VK12034/exo-arm/cad/README.md

# CAD

BudgetExoArm

The mechanical design, as modelled in Fusion 360.

| File | What it is |
|---|---|
| `source/BudgetExoArm.f3d` | Fusion archive of the design |
| `step/BudgetExoArm.step` | STEP export, openable without Fusion |
| `mesh/BudgetExoArm.stl` | Mesh export. GitHub renders this in the browser |
| `BudgetExoArm.design.json` | Every component, body and joint, with mass, volume and centre of mass |
| `BudgetExoArm.bodies.csv` | The same body data as a spreadsheet |
| `parts/` | One STL per 3D-printed part, in model position, so lay each flat in the slicer |

All of these except the image are generated by `tools/fusion/ExoArmExport.py`.
Run it again after any design change so the numbers below, and the constants
in the firmware, stay tied to the model rather than to memory.

## Regenerating

The script is installed per-machine, not from this repository:

1. Copy `tools/fusion/` contents into a folder named `ExoArmExport` under
   `%APPDATA%\Autodesk\Autodesk Fusion 360\API\Scripts\` (Windows) or
   `~/Library/Application Support/Autodesk/Autodesk Fusion 360/API/Scripts/` (macOS)
2. Open the design, then **Utilities → Scripts and Add-Ins → ExoArmExport → Run**
3. Point it at this `cad/` folder

It only reads and exports. It also refuses to run if the timeline marker is
not at the end, because a rolled-back timeline exports a mid-edit state as if
it were the design. That happened once, and this repository described the wrong
machine until it was caught.

## Coordinate frame

Fusion's origin sits at the wearer's right shoulder. Z is up, so the arm
hangs in −Z. X runs forward, the direction the forearm points in the modelled
pose. Y runs to the wearer's left, where the drivetrain is mounted.

Figures are millimetres and kilograms, taken from the model unless marked as
calculated.

## Layout

| Item | Position (mm) | Notes |
|---|---|---|
| Shoulder centre | (0, 0, −10) | Wearer reference |
| Elbow axis | Along Y, through x = 0, z = −330 | M8 shoulder bolt in two bronze bushings |
| Gearbox output and 15T sprocket | Along Y, through x = 0, z = −172 | 158 mm above the elbow |
| 30T elbow sprocket | y 77.6 to 82.9 | Moves with the forearm |
| Upper strut | y 62.0 to 66.8, z −374 to −64 | 1.5 × 3/16 in 6061 |
| Forearm strut | y 67.8 to 72.6, x −33 to 253 in the modelled pose | 1 × 3/16 in 6061 |
| Forearm cuff | Centred at x = 193 | 193 mm from the elbow |

## Elbow travel

"Flexion" here means the true angle from a straight arm. The modelled pose is
90°, with the upper arm along −Z and the forearm along +X.

| Point | True flexion | Firmware angle | Source |
|---|---|---|---|
| Extension stop contact | about 21.2° | about −2.4° | Calculated from the measured gap at the joint limit |
| Fusion joint limit, extension | 22° | −1.5° | Joint limit |
| Home switch closes | about 23.5° | 0° | Modelled target, see below |
| Flexion soft limit | about 111.5° | 88° | `kMaxAngleDeg` |
| Overrun switch closes | about 114.5° | 91° | Modelled target, `kFlexSwitchAngleDeg` |
| Fusion joint limit, flexion | 117° | 93.5° | Joint limit |
| Flexion stop contact | about 117.6° | about 94.1° | Calculated from the measured gap at the joint limit |

So the arm never fully straightens, and travel is about 96° between the stops.
The firmware's zero is the home switch, not a straight arm: add about 23.5° to
a firmware angle to get true flexion.

The hard stops are 7 mm steel spacers in 10 mm OD rubber sleeves on the upper strut,
each 30 mm from the pivot, and the forearm strut's edge strikes the rubber. The
sleeves keep the same 10 mm contact as the original spacers, so the stop angles did
not change, though the rubber will compress a little under load. Their M5 × 10 bolts
screw into tapped spacers and must end below the top of the spacer, because the clutch
plate sweeps over them.

## Switch mounts

Two KW12-style lever microswitches, each on a 3 mm 6061 bracket on the inboard
face of the upper strut, with the switch standing on 4.9 mm spacers so the
lever sits in the forearm strut's plane. Each bracket takes two M3 screws
through 3.2 mm holes in the upper strut, and the switches use 2.4 mm holes on
9.5 mm centres.

Checked by rotating the real elbow joint through its limits at 15 poses:

| Check | Result |
|---|---|
| New parts clashing with anything except the strut pressing a lever | None |
| Home lever first touched | About 25.6° true flexion |
| Overrun lever first touched | About 112.1° true flexion |
| Strut to home switch body at the 22° joint limit | 2.0 mm |
| Strut to overrun switch body at the 117° joint limit | 1.3 mm |
| Mass of every other existing body after the work | Unchanged |

**The closing angles are a target, not a measurement.** The levers are simple
modelled shapes placed so a real switch with about 1.2 mm of lever pre-travel
would close at the target angle. Real switches differ, so
[commissioning](../docs/commissioning.md) measures both closing points on the
built arm, and those measurements decide.

## Control box and pendant

Both enclosures are sized for real parts rather than the model's earlier simple blocks.

**Control box**, 58 × 156 × 116 mm outside, with 3 mm walls. It opens toward the lid, away
from the wearer, and the belt loops are part of its closed back wall.

| Feature | Size |
|---|---|
| Uno bosses | 7 mm OD × 6 mm, Ø2.5 pilots, on the Uno's standard hole pattern |
| TB6600 | Space for 96 × 71 × 37 mm. Mounting holes vary by maker, so mark and drill the back wall from yours |
| Glands | Ø12.5 in the top and end walls |
| USB opening | 14 × 16 mm in the end wall, so the Uno can be flashed with the lid on. Check it against your board |
| Vents | 5 slots in the lid over the driver, 4 in the end wall beside it |
| Lid | Rocker 19.2 × 13 mm, LED Ø6.2, barrel jack Ø12, 4 Ø3.4 screw holes into Ø2.5 pilots |

The barrel jack moved to clear the driver. The fuse, capacitor and wiring are not modelled,
and nothing has been test-fitted.

**Pendant**, 50 × 108 × 55 mm outside, 3 mm walls. That leaves 49 mm behind the panel,
because published 22 mm e-stops range from about 18 to 72 mm deep, and typically 37 to
46 mm. Check yours. It has Ø16 button holes, a Ø22.3 e-stop hole, a Ø9 cable hole, and a
screw-on back cover that carries the belt clip. It is bigger than before, and neither the
grip nor the weight with real switches has been tried.

Checked with the enclosures in place: no overlaps inside the harness apart from the cables
entering their glands, and neither enclosure touches the reference wearer.

## Chain tension

The gearbox plate's three standoffs run in slots in the upper strut, 5.5 mm wide and
15.5 mm long overall, so the plate slides about 5 mm each way along the strut. Slide it
away from the elbow to tighten the chain, then tighten the M5 × 35 bolts.

## Chain guard

A printed PETG channel around the chain and both sprockets, y 73.6 to 90, with 2 mm
walls. It is held by two pillars at x = ±8, z = −276 with M3 screws through the upper
strut. There is no cover under the gearbox plate, which roofs that end, and the
forearm strut passes underneath the walls. The rigidity of a 2 mm channel on two
pillars is a guess until one is printed.

## Encoder mount

A printed cup screwed to the clutch's outer plate turns with the forearm and carries a 6
× 2.5 mm diametric magnet on the elbow axis, clear of the stationary M8 nut. The clutch
nuts and springs pass through holes in it. An AS5600 board on an arm from the chain
guard sits above it with a 1.5 mm gap.

Printed tolerances and the guard's stiffness could still close the 1.5 mm gap or
misalign the magnet, and so could moving the outer plate when the clutch is adjusted.

## Torque limiter

A friction clutch between the 30T sprocket and the forearm, fully described in
[torque-limiter.md](../docs/torque-limiter.md). It takes the 5 mm that the sprocket
spacers used, so the sprocket and chain line have not moved.

Checked at 11 elbow angles across the joint's full range, for the clutch parts,
sprocket, cup and nuts:

| Check | Result |
|---|---|
| Clashes with the upper arm, switches and guard | None, leaving aside the chain, which is modelled as a fixed loop with teeth that do not follow the sprocket |
| Overlaps within the forearm stack | None |
| Plate to the top of the overrun and home switches | 0.8 mm |
| Plate edge to the modelled chain | 2.0 mm |
| Bodies not deliberately changed | Mass unchanged |

The bolts' shanks and the countersinks for the two extra bolts are not modelled.

## Mass

| Component | Mass (kg) | Bodies | Notes |
|---|---|---|---|
| Upper Arm Module | 2.370 | 43 | Gearbox 1.10, motor 0.55, chain 0.27, struts, cuff, 15T sprocket |
| Harness + Electronics | 0.713 | 28 | Waist belt, control box, pendant. Carried by the torso |
| Forearm Module | 0.600 | 29 | Clutch 0.255, bored 30T sprocket 0.174, strut, cuff, magnet cup |
| Chain Guard | 0.044 | 2 | Guard and encoder board |
| Switch Mounts | 0.013 | 10 | Added for the home and overrun switches |
| **Device total** | **3.741** | 112 | |
| Ref - Wearer Torso | 6.213 | 8 | Reference mannequin, not part of the device |
| Ref - Wearer Upper Arm | 0.336 | 2 | Reference solid |
| Ref - Wearer Forearm | 0.185 | 4 | Reference solid |

The motor's 0.55 kg is the listing's gross weight, spread over its modelled bodies. The
gearbox's 1.10 kg is its share of an earlier estimate for the whole gearmotor, not a
figure for the part you will buy.

The `Ref - Wearer` bodies are shape references at an arbitrary density. Their
masses are **not** anthropometric and must not be used for load calculations.
Use published segment fractions against the wearer's own body mass instead.

Bronze bushings are still assigned steel in the model. The error is a few grams and does
not affect any figure here. The clutch adds about 0.17 kg, almost all of it close to the
elbow axis, so the static load does not change.

## Drivetrain

| Item | Value |
|---|---|
| Motor | NEMA 23 stepper, 41 mm body, 0.55 N·m holding |
| Gearbox | NMRV030 worm, 30:1 |
| Chain stage | #35, 15T to 30T, 2:1, 56 links |
| Overall ratio | 60:1 |
| Resolution | 200 full steps × 4 microsteps × 60 = 48 000 steps per elbow revolution |
| Ideal output | 33 N·m calculated, before worm and chain losses |
| Assist | 1/4 in shock cord, 3 loops, between the upper arm and a pin on the forearm |

Catalogue efficiencies give 12 to 21 N·m at the elbow at full motor torque. See
[loads](../docs/loads.md).

**The worm should hold, but that is untested.** Motovario lists the NMRV030 at 30:1
with a static efficiency of 0.39, below the 0.5 it requires. Vibration can still affect
that, and a chain failure would release the forearm whatever the worm does.

## Electronics

| Item | Where |
|---|---|
| Arduino Uno | Control box, waist belt |
| TB6600 stepper driver | Control box, waist belt |
| 24 V barrel jack, rocker switch, green status LED | Control box face |
| UP and DOWN momentary buttons | Hand pendant |
| E-stop, latching mushroom, normally closed | Hand pendant |
| PG7 glands, 6-core pendant cable, 4-core motor cable | Control box |
| Buck converter, e-stop relay, ACS712 | Control box, on the back wall |
| AS5600 encoder board | On the chain guard, over the elbow axis |

## Materials

| Material | Used for |
|---|---|
| PETG, FDM, 4 walls at 40% infill | Cuffs, gearbox plate, control box, pendant housing, strap anchor, chain guard, magnet cup |
| Aluminium 6061 | Upper and forearm struts, standoffs, switch brackets and spacers |
| Steel | Sprockets, clutch plates and shim, hard stop spacers, pivot bolt, fasteners, shaft key |
| Aluminium 6061, machined | Clutch hub |
| Organic friction sheet, 1 mm | Clutch facings, density assumed |
| Rubber | Hard stop sleeves |
| EVA foam, 5 mm | Cuff pads |
| Nylon webbing, 25 and 38 mm | Sling strap, waist belt |

## Not modelled or not checked

- [First-pass stall loads](../docs/loads.md) exist, but contact stress, strut bending,
  the gearbox plate and the shoulder mount have not been checked.
- The encoder and sensor wiring runs are not modelled.
- [The clutch](../docs/torque-limiter.md) has not been built, and its friction is assumed.
