VK12034/exo-arm/cad/BudgetExoArm.bodies.csv

occurrence | component | body | material | mass_kg | volume_mm3 | com_x_mm | com_y_mm | com_z_mm | size_x_mm | size_y_mm | size_z_mm
/Ref - Wearer Torso:1 | Ref - Wearer Torso | Torso | Fabric | 4.829456602230147 | 31772740.80414571 | -5.614805690907065 | -190.00000003856738 | -222.48301347356352 | 226.6768406649028 | 344.0099099489128 | 660.0
/Ref - Wearer Torso:1 | Ref - Wearer Torso | Head + Neck | Fabric | 0.6488113729929531 | 4268495.874953639 | -5.90256741804378 | -189.99999999999997 | 250.62307297081225 | 184.00000000000003 | 184.00000000000006 | 298.7323711720972
/Ref - Wearer Torso:1 | Ref - Wearer Torso | Right Shoulder | Fabric | 0.105930315488843 | 696909.9703213357 | 0.0 | 0.0 | 0.0 | 110.0 | 110.0 | 110.0
/Ref - Wearer Torso:1 | Ref - Wearer Torso | Left Shoulder | Fabric | 0.105930315488843 | 696909.9703213357 | 0.0 | -380.0 | 0.0 | 110.0 | 110.0 | 110.0
/Ref - Wearer Torso:1 | Ref - Wearer Torso | Left Elbow | Fabric | 0.040748551112162 | 268082.573106329 | 0.0 | -392.0 | -324.99999999999994 | 80.0 | 80.0 | 80.0
/Ref - Wearer Torso:1 | Ref - Wearer Torso | Left Upper Arm | Fabric | 0.29368025524048713 | 1932106.9423716262 | -1.949298901233054e-09 | -392.0000000024876 | -153.09499201817775 | 100.0 | 99.99999999999993 | 300.0
/Ref - Wearer Torso:1 | Ref - Wearer Torso | Left Forearm | Fabric | 0.15452853175261724 | 1016635.0773198503 | 8.000000010371723 | -391.99999999577216 | -439.86280866117124 | 82.04809064756624 | 82.00000000000017 | 260.0
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
/Switch Mounts:1 | Switch Mounts | Home Switch Lever | Steel | 0.00032970000000000346 | 42.00000000000045 | 5.043051536939504 | 70.10000000000001 | -376.3318479147528 | 4.980608172205213 | 4.0000000000000036 | 21.132382186036267
/Switch Mounts:1 | Switch Mounts | Overrun Switch (KW12 lever microswitch) | ABS Plastic | 0.0013839359999999969 | 1305.599999999997 | 27.56548476648384 | 70.10000000000002 | -294.03009522408007 | 22.429096492624495 | 6.400000000000006 | 17.575469816065485
/Switch Mounts:1 | Switch Mounts | Overrun Switch Lever | Steel | 0.00029829999999999695 | 37.999999999999616 | 29.29000751795808 | 70.10000000000001 | -301.43134655609464 | 15.754899148826231 | 4.0000000000000036 | 12.155989583588322
/Chain Guard:1 | Chain Guard | Chain Guard (PETG print) | PETG (FDM, 4 walls + 40% infill) | 0.043406859728983144 | 48229.84414331461 | -0.83923797726671 | 86.07541876420662 | -285.4236275357099 | 112.00000000000001 | 37.2 | 256.0
/Chain Guard:1 | Chain Guard | AS5600 Encoder Board | ABS Plastic | 0.0008971839999999998 | 846.3999999999999 | 0.0 | 101.19999999999999 | -330.0 | 23.000000000000004 | 1.6000000000000014 | 22.99999999999997
