VK12034/exo-arm/cad/mesh/BudgetExoArm.stl

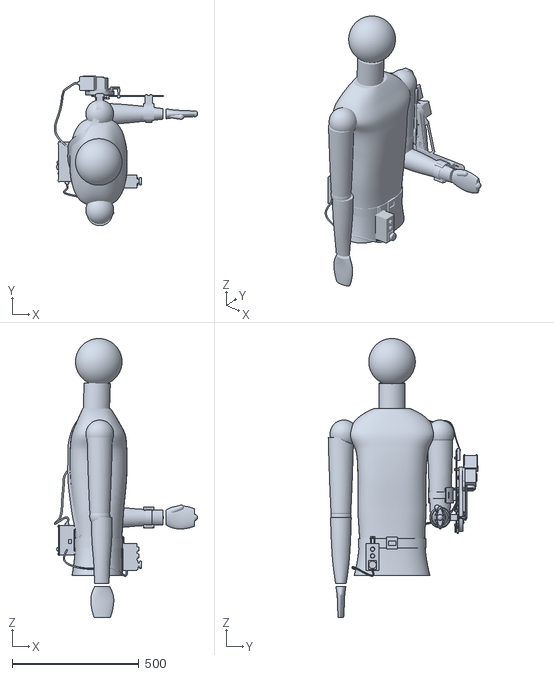
[picture p2: CAD file, 2026-11-09]
cad/mesh/BudgetExoArm.stl
566.7 x 590.5 x 1102.0
