VK12034/exo-arm/cad/parts/hand-pendant-back-cover.stl

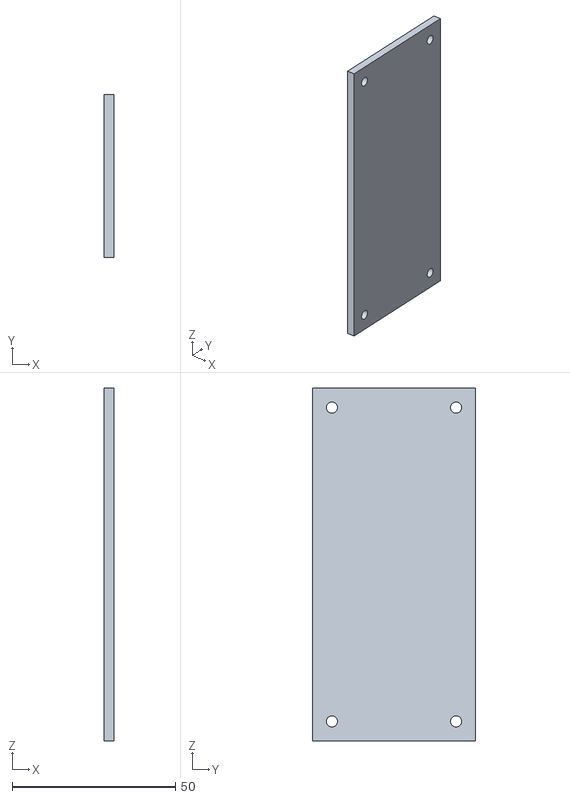
[picture p3: CAD file, 2026-11-09]
cad/parts/hand-pendant-back-cover.stl
3.00 x 50.0 x 108.0
