VK12034/exo-arm/cad/parts/sling-strap-anchor.stl

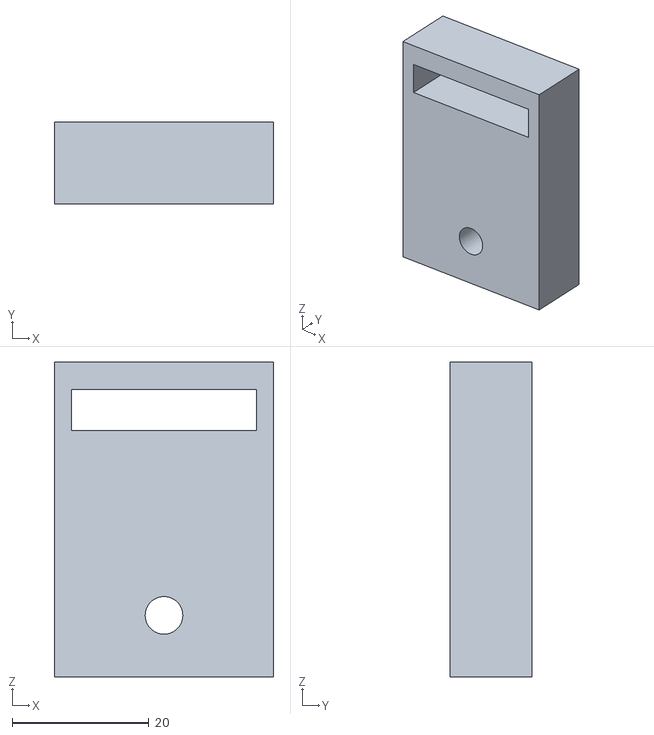
[picture p4: CAD file, 2026-11-09]
cad/parts/sling-strap-anchor.stl
32.0 x 12.0 x 46.0
