VK12034/exo-arm/cad/parts/control-box-body.stl

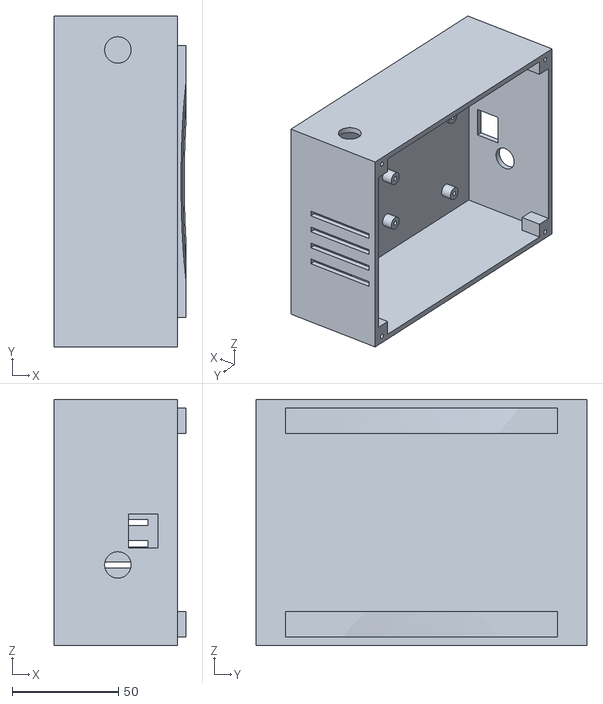
[picture p5: CAD file, 2026-11-09]
cad/parts/control-box-body.stl
62.0 x 156.0 x 116.0
