VK12034/exo-arm/cad/parts/control-box-lid.stl

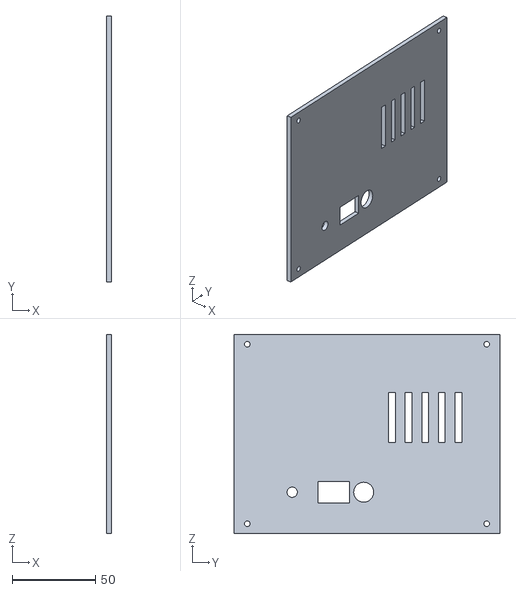
[picture p6: CAD file, 2026-11-09]
cad/parts/control-box-lid.stl
3.00 x 160.0 x 120.0
