VK12034/exo-arm/cad/parts/hand-pendant-housing.stl

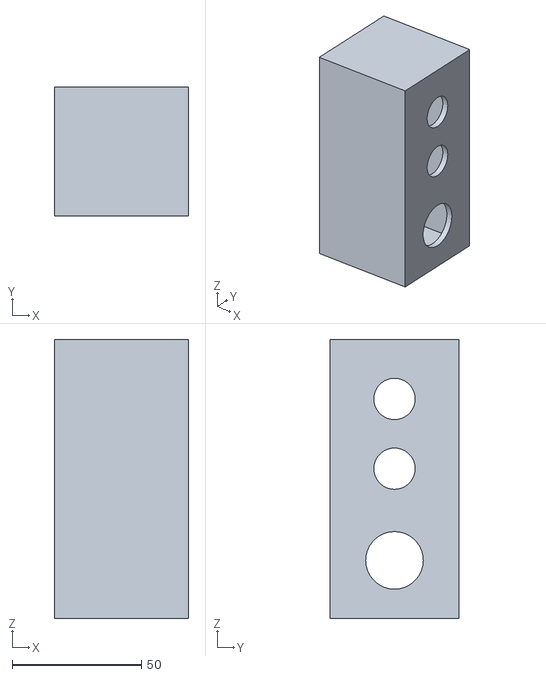
[picture p7: CAD file, 2026-11-09]
cad/parts/hand-pendant-housing.stl
52.0 x 50.0 x 108.0
