VK12034/exo-arm/cad/parts/encoder-magnet-cup.stl

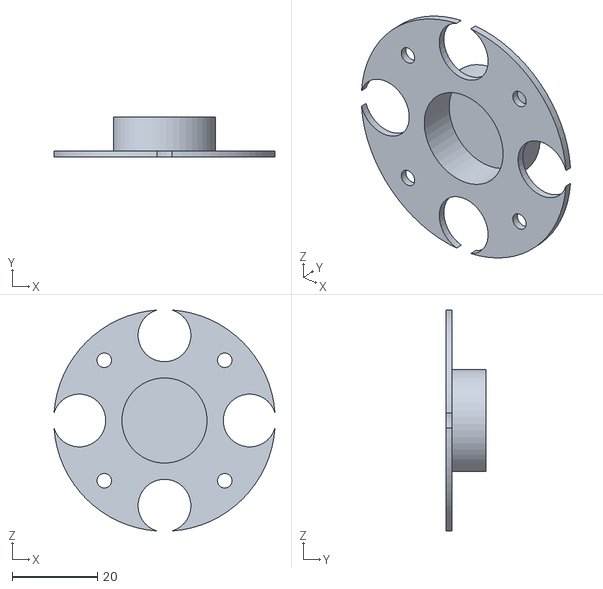
[picture p8: CAD file, 2026-11-07]
cad/parts/encoder-magnet-cup.stl
51.9 x 9.50 x 51.9
