VK12034/exo-arm/cad/parts/chain-guard.stl

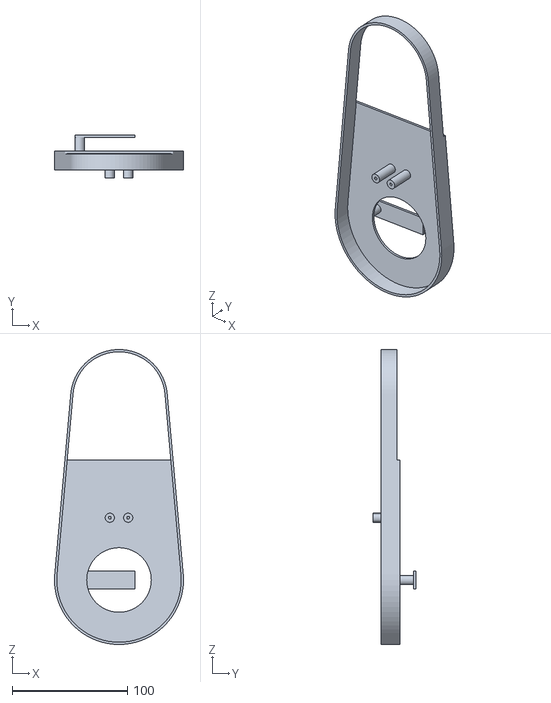
[picture p9: CAD file, 2026-11-07]
cad/parts/chain-guard.stl
112.0 x 37.2 x 256.0
