VK12034/exo-arm/cad/parts/forearm-cuff.stl

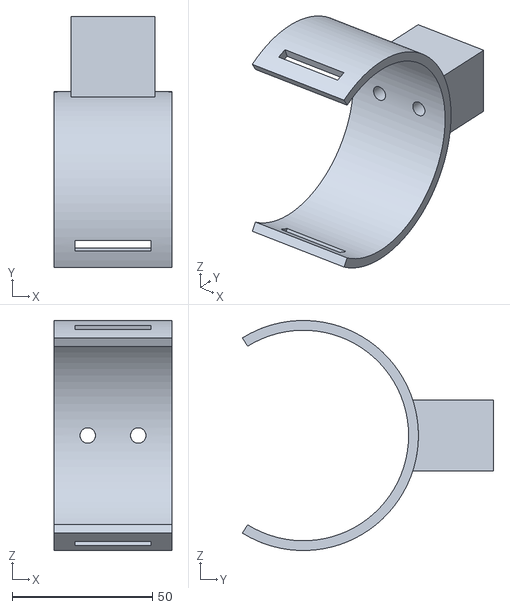
[picture p10: CAD file, 2026-11-07]
cad/parts/forearm-cuff.stl
42.0 x 89.5 x 82.0
