VK12034/exo-arm/cad/parts/upper-arm-cuff.stl

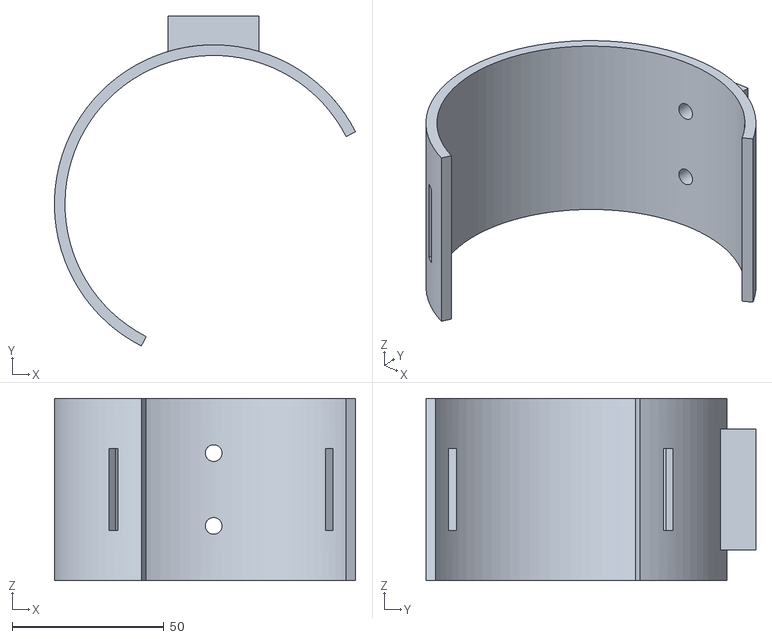
[picture p11: CAD file, 2026-11-07]
cad/parts/upper-arm-cuff.stl
99.3 x 108.8 x 60.0
