VK12034/exo-arm/cad/parts/gearbox-plate.stl

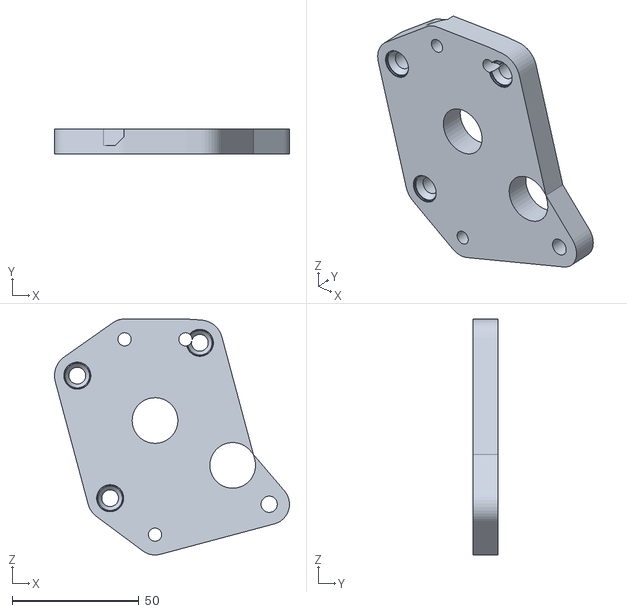
[picture p12: CAD file, 2026-11-07]
cad/parts/gearbox-plate.stl
92.6 x 10.0 x 93.0
