VK12034/exo-arm/(list of files, cad)

Other CAD files:
cad/step/BudgetExoArm.step
cad/source/BudgetExoArm.f3d
