VK12034/exo-arm/docs/wiring.md

# Wiring

Arduino Uno, 5 V logic. The pin assignments below are the firmware's, from
`firmware/include/config.h`; change the two together.

## Pin map

### TB6600 stepper driver

The TB6600's inputs are opto-isolated pairs. These pins drive the negative
sides with the positive sides tied to 5 V, so a pin pulled **low** activates
that input.

| Signal | Uno pin | TB6600 | Notes |
|---|---|---|---|
| Step | 3 | PUL− | 4 µs pulse, up to about 2.7 kHz at full speed |
| Direction | 4 | DIR− | Settled before the next pulse by the firmware |
| Enable | 5 | ENA− | Low energises the motor |
| 5 V | 5V | PUL+, DIR+, ENA+ | Common positive |

Set the DIP switches for **1/4 microstepping** and **2.0 A** to start, and never above
the motor's rated 2.8 A. `cfg::kMicrosteps` must match the switches. Step 7 of
[commissioning.md](commissioning.md) checks that it does, by measuring the
home-to-overrun span, but nothing checks it while the arm is running, and a
mismatch scales every angle in the firmware by the same wrong factor.

The current setting is also the only torque limit this machine has. Stepper
torque follows phase current, and the TB6600 holds phase current at whatever
these switches say, so this is what decides how hard the arm can push. The
firmware cannot reduce it: see the torque entry in
[safety.md](safety.md#known-gaps). Set it no higher than the arm needs.

### Pendant

Six-core cable to the hand unit, through a PG7 gland.

| Signal | Uno pin | Wiring |
|---|---|---|
| UP button | 6 | Momentary to GND, internal pull-up |
| DOWN button | 7 | Momentary to GND, internal pull-up |
| E-stop | 2 | **Normally closed** to GND, internal pull-up |
| GND | GND | Common return |

Two cores spare. Use one as a second ground rather than leaving it floating.

The e-stop must be the normally-closed contact of the latching mushroom. A
normally-open contact would read as "safe" when the cable is cut, which is
exactly backwards.

### Home switch

A lever microswitch at the extension end of travel, which is what gives the
firmware a real zero instead of an assumed one.

| Signal | Uno pin | Wiring |
|---|---|---|
| Home switch | 9 | **Normally open**, closing to GND, internal pull-up |

Note that this is the opposite convention to the e-stop, and for the same
reason: pick the polarity by how it fails.

- **Normally open**, as specified. A cut cable or an unplugged switch reads
  open forever. The arm never homes, so it stays on its restricted travel and
  runs slow. The failure is visible in the status output and costs range, not
  safety.
- **Normally closed**, which would be wrong here. The same cut cable reads as
  "at home", and the firmware would adopt a zero wherever the arm happened to
  be, then open up the full travel on the strength of it. A broken wire would
  silently move every limit.

The e-stop is normally closed because for a stop command, the safe assumption
on a broken wire is "stop". The home switch is normally open because for a
position reference, the safe assumption on a broken wire is "I do not know
where I am".

**Mounting.** The model has a 3 mm aluminium bracket for it on the inboard face
of the upper strut, with the lever in the forearm strut's plane. See
[cad/README.md](../cad/README.md).

**Siting it matters.** The switch can only be acted on once it closes, so the
arm travels a little further while stopping, and that overshoot has to fit
between the switch and the hard stop. The firmware seeks at 5 °/s, which is
0.28° of stopping distance at 45 °/s², so a degree of clearance is ample.
The model targets closing about 2.5° before the hard stop. It must stay closed
all the way to the stop, rather than closing exactly at the stop. A switch that
closes only at the very end can be driven past before the firmware reacts.

### Overrun switch

A second lever microswitch, sited **past** the flexion soft limit rather than
at it.

| Signal | Uno pin | Wiring |
|---|---|---|
| Overrun switch | 10 | **Normally open**, closing to GND, internal pull-up |

Same polarity as the home switch, same reasoning. It closes at a firmware angle
of about **91°**, three degrees beyond the 88° soft limit and about three before
the flexion hard stop.

This one is not a limit. The planner stops at 88° and the step generator
refuses to pulse past it on its own arithmetic, so reaching this switch means
both of those failed. That is why it faults rather than merely stopping.

Siting it is a compromise in both directions:

- **Too close to the soft limit** and a normal full-flexion stop brushes it,
  which means nuisance faults and a safety device that gets disconnected.
  Three degrees is several times any plausible overshoot.
- **Too far past it** and the arm travels further into trouble before anything
  notices, with less room left before the hard stop.

Note the failure mode. A broken home switch announces itself within a session,
because the arm never homes and says so. A broken overrun switch is silent
until the day it is needed, and that day is already a bad one. Step 7 of
[commissioning.md](commissioning.md) is the only thing that proves it works,
so do it rather than assuming.

Its bracket is in the model too. See [cad/README.md](../cad/README.md).

### Panel

| Signal | Uno pin | Notes |
|---|---|---|
| Status LED | 8 | Green LED on the control box face, with its series resistor |
| Onboard LED | 13 | Mirrors the status LED, useful on the bench |
| Current sense | A0 | ACS712-20A output, 100 mV/A about a mid-rail zero |

Pins 11, 12 and A1 to A3 are unused. A4 and A5 are the encoder's I2C bus.

### Encoder

| Signal | Uno pin | Notes |
|---|---|---|
| SDA | A4 | AS5600 board, address 0x36 |
| SCL | A5 | |
| 5 V, GND | 5V, GND | Check the board accepts 5 V, or supply it to suit |

I2C was not designed for long cables beside a stepper driver, and this run goes from
the belt to the elbow. Use a shielded twisted pair, route it away from the motor cable,
and keep the bus speed down if reads fail. The firmware tolerates a few failed reads,
then faults once and carries on step-counted, so `enc=LOST` in the status line is the
sign of a wiring problem.

### Current sensor

An ACS712-20A goes **in the 24 V feed to the TB6600**, downstream of the
e-stop contact, so it sees the driver's draw and nothing else. Its 5 V and
ground come from the Arduino, and its output goes to A0.

Put it on the driver feed, not on the supply input: the buck converter and
the Arduino would otherwise appear in the reading as a constant offset that
drifts with whatever the logic is doing.

The firmware measures the sensor's zero at every power-on, with the driver
de-energised. Nothing may be moving during the first second after power-up or
that reading becomes the zero point for the whole session.

## E-stop, in hardware as well as firmware

The firmware reads the e-stop and stops. That is not enough on its own: it
depends on the firmware working. The same loop must also break the **24 V
supply to the TB6600**, through a relay or a contactor rated for it.

```
24 V ──[fuse]──┬──── relay contact (NO) ──── ACS712 ──── TB6600 VCC
               │
               └──── 24 V → 5 V buck ──┬──── Arduino 5V pin
                                       │
                                       └──── relay coil ──┬──── pin 2
                                                          │
                                                      E-STOP NC ──── GND
```

The mushroom's one normally-closed contact does both jobs. Use a 5 V relay with a bare
coil, not an opto-isolated module, and put a 1N4007 flyback diode across the coil with
its cathode on the 5 V side. With the loop closed, the coil pulls in and pin 2 reads low.
With it open, or the cable cut, the relay drops out and pin 2 reads high through the coil.

Wired this way the Arduino stays alive with the loop open, so it can see the
fault, light the LED and refuse to resume — while the motor is dead
regardless of what any code does.

**Feed the buck's 5 V to the Uno's 5V pin, not VIN.** VIN goes through a regulator that
needs about 7 V or more. Set the buck to 5.0 V with a meter before connecting it, because
the 5V pin has no protection from a wrong voltage.

Do not power the Arduino from USB and the buck at the same time while the
motor supply is live.

## Power

| Item | Value |
|---|---|
| Supply | 24 V, at least 4 A for a NEMA 23 at full current |
| Fuse | Inline, sized to the driver's current setting |
| Bulk capacitance | Electrolytic across the TB6600 supply terminals, as close as the layout allows |
| Logic | 24 V → 5 V buck to the Arduino 5V pin |

A stepper driver chops current continuously, and the 24 V rail sags hard on
direction reversals. Commission on a current-limited bench supply before
anything else.

## Cabling

The motor cable runs from the belt to the gearmotor on the upper arm, so it
flexes as the arm moves relative to the torso. It is the cable to expect to fail
first. Give it a service loop, strain-relieve both ends, and use a locking
connector so replacing it is a five-minute job rather than a rebuild.

Keep the motor cable away from the pendant cable. A TB6600 switching amps at
the far end of a long run will couple into button lines, and a false button
read is motion nobody asked for.
