VK12034/exo-arm/docs/commissioning.md

# Commissioning

Work through this in order, with the arm **on the bench and not worn**, until
the last step. The firmware has never run on hardware, so treat every step as
a test of the firmware as much as of the build.

Keep the supply current-limited throughout. A limit of about 1 A is enough to
move the arm unloaded and not enough to do damage when something is wrong.

The model includes hard stops and switch mounts, but neither has been built or
load-tested. Do not treat "it stopped" as evidence that a backstop would hold
under full motor torque.

Step 7 defeats the flexion soft limit on purpose. Read its warning before
starting it, not during.

## 1. Driver alone, motor disconnected

Flash the firmware and open the monitor:

```bash
cd firmware
pio run -e uno -t upload
pio device monitor
```

Expect, at power-on:

```
exo-arm elbow ready
travel 0-88 deg, 133.3 steps/deg
unhomed: travel held to 60 deg at 5 deg/s until the extension switch is reached
```

and then nothing until the e-stop reads closed, because the firmware boots
into fault on purpose.

- Status LED blinking fast: fault. Close the e-stop loop.
- `ready` printed and the LED blinking slowly: the interlocks are working.

If it prints `FAULT: estop` with the mushroom released, the loop is wired
normally-open. Fix that before going further — a normally-open e-stop reads
as safe when the cable is cut.

## 2. Buttons

With the motor still disconnected, press each button and watch the status
line. UP should show a positive `v=`, DOWN negative, both together zero.

If UP and DOWN are swapped, swap the wires rather than the pin numbers — the
label on the pendant is what the wearer trusts.

## 3. Direction, motor connected, arm not attached

**This is the step that hurts someone if it is wrong.** Connect the motor but
leave the chain off the sprockets, so a wrong direction turns a sprocket instead
of an arm.

Press UP. The 15T sprocket must turn in the direction that would **flex** the
elbow. If it turns the other way, set `kInvertDirection` to `true` in
`firmware/include/config.h` and reflash.

Do not fix this by swapping motor phases: the firmware's idea of direction
and the physical direction must agree, and the constant is where that is
recorded.

## 4. Steps per degree

Still with the chain off. Mark the 15T sprocket, hold UP until the status line
reads 45°, and measure the sprocket's rotation with a protractor. It turns twice
as far as the elbow will.

| Reading | Meaning |
|---|---|
| Sprocket moved ≈ 90° | `kMicrosteps` and `kGearRatio` agree with the hardware |
| Sprocket moved ≈ 45° | Driver is set to 1/8, firmware expects 1/4 |
| Sprocket moved ≈ 180° | Driver is set to 1/2 |

The DIP switches on the TB6600 and `cfg::kMicrosteps` must match. Nothing in
the firmware can detect a mismatch, and every angle, limit and speed is wrong
by the same factor when they disagree.

## 5. Home switch

Still with the chain off, motor connected. This is the step that decides whether the
travel limits mean anything, so do it before trusting any of them.

First, the switch on its own. With the arm away from the switch, the status
line must read `home=open` and `zero=UNHOMED`. Press the lever by hand:
`home=` must go to `closed`, and the monitor must print

```
homed: zero set at the extension switch
```

If `home=` reads `closed` with nothing touching the lever, the switch is
wired normally closed. Fix it. Wired that way a broken wire invents a zero
wherever the arm happens to be, which is the failure this polarity exists to
avoid: see [wiring.md](wiring.md).

If pressing the lever does nothing, check the wiring before assuming the
firmware. An unplugged switch and a working switch that is simply never
reached look identical from the status line.

Now the siting. Fit the chain, park the arm away from the extension stop, power cycle so it comes up unhomed, then hold DOWN and let it
seek. Measure two things:

- [ ] **Where it closes.** The switch must close **at least 1° before** the hard
      stop, about 2.5° in the model, and stay closed to the stop. Closing exactly at the stop leaves no
      room for the arm to stop in.
- [ ] **Where it stops.** At 5°/s the arm should come to rest within a
      fraction of a degree of the switch, and must not reach the hard stop.
      If it does, the switch is sited too late or `kHomingSpeedDegPerSec` is
      too high.

Then confirm the restriction lifts: once homed, the status line must show
`zero=switch`, and holding UP must now ramp to 20°/s and run past 60°. Before
homing it must do neither.

Finally, the correction itself. Home the arm, flex to roughly 30°, extend
back to the switch, and read the number it reports:

```
homed: zero set at the extension switch, counter was out by 7 steps (0.11 deg)
```

A handful of steps is the healthy answer, and under half a degree it will say
nothing at all. Do this five or six times. You do not need to write the
figures down: anything over half a degree goes into the EEPROM log and is
printed at the next power-on, tagged with its session. That is the baseline.
A build reporting a tenth of a degree per trip now and whole degrees in a
month is losing steps, and the cause is mechanical.

Power cycle once here and confirm the log comes back with what you just did
in it. If it prints `initialised empty` every time, the EEPROM is not
retaining, and the drift trend is the one diagnostic this machine has for
step loss.

**On deliberately provoking the fault.** Resist the temptation to fake a
drift with the re-zero gesture. Asserting a zero sets the soft minimum to
that pose, so the arm can no longer extend toward the switch and you cannot
reach it to trigger anything; recovering needs a power cycle. The fault path
is covered by the host tests (`pio test -e native`) instead.

Worth knowing while you are here: the detection is one-sided in practice.
Lost steps leave the arm physically **more** extended than the counter
claims, so it reaches the switch with the count still reading positive, which
is exactly what gets measured. The opposite error cannot be seen, because the
soft minimum stops the arm at a reported 0° before the switch is reached. The
state machine handles both; only one of them can happen to you.

## 6. Travel limits

With the chain on, park at the extension stop and power cycle; confirm it
prints `homed:` and shows `zero=switch` before going on, because an unhomed
arm stops at 60° and this step would look like a failure. Then hold UP and
let it run to the limit without touching anything.

- It must come to a **stop**, not a halt: the last part of the travel is a
  deceleration ramp.
- It must stop short of the mechanical hard stop.
- The status line must read close to 88°.
- Measure the real elbow travel with a protractor. It must match the status line
  to within a degree or two, which also confirms the chain ratio.

Repeat with DOWN to the extension limit.

If it reaches a hard stop, stop and work out why before continuing. The park
is no longer a candidate once the arm has homed, so it is the steps-per-degree
or steps being lost.

## 7. Overrun switch and the span

The flexion switch is not a travel limit. It sits three degrees past
`kMaxAngleDeg`, so reaching it means the planner failed to decelerate at the
soft limit **and** the step generator's independent clamp failed to stop
pulsing past it. It is the first thing on this machine that catches the
firmware being wrong rather than an assumption going stale.

Which also makes it the hardest thing to test, because you have to make the
firmware wrong on purpose.

**Keep the arm unworn, with a current-limited supply.** This step deliberately
defeats the flexion soft limit, and the span can only be measured with the chain
on, because the forearm strut is what closes the switch.

First, the switch on its own, before any of that. Press the lever by hand
with the arm stopped mid-travel. The monitor must fault:

```
FAULT: flexion switch reached - both soft limits were passed
span measured 12134 steps, expected 12133 - agrees
```

If `flex=` in the status line reads `CLOSED` with nothing touching it, the
switch is shorted or on the wrong pin. If pressing the lever does nothing at
all, it is not wired. That one matters more here than for the home switch: a
broken home switch is obvious within a session because the arm never homes,
but a broken overrun switch is invisible until the day it is needed.

A closure while the counter reads near zero reports differently, and should,
because at that point the switch is telling you about itself:

```
FAULT: flexion switch closed with the counter near zero - shorted switch, wrong pin, or parked at full flexion
```

### Measuring the span

Now the part worth the trouble. The switch is at a fixed place on the
machine, so the step count when it closes is the distance from the home
switch to here, measured rather than calculated. It is the only number on
this arm that can be checked against a physical length.

1. Home the arm against the extension switch.
2. Raise `kMaxAngleDeg` to 93 in `config.h` and reflash, so the planner will
   drive to the switch. Go no higher: the flexion stop is only about 3° past it.
   If the switch does not fault the arm, press the e-stop.
3. Hold UP and let it run until it faults.
4. Read the span from the fault message, or at the next power-on from the log.
5. **Put `kMaxAngleDeg` back to 88 and reflash.** Do not leave it raised.

Expect agreement within two degrees. A disagreement is worth more than it
looks:

| Span reads | Means |
|---|---|
| ≈ expected | Microstepping, gear ratio and switch siting all agree |
| ≈ half | TB6600 is set to 1/8 and `kMicrosteps` says 1/4 |
| ≈ double | TB6600 is set to 1/2 |
| A few degrees out | Switch siting, or lever flex. Adjust the switch, not the constant |
| Shrinking over repeat runs | Steps being lost on the way up |

The halved and doubled cases are the ones step 4 could only check with a
protractor by eye. This is the firmware checking it, and it is the only
mechanism in the build that can: nothing else compares a step count against a
distance. If the span disagrees by a factor, fix the DIP switches rather than
`kMicrosteps`, because every speed and acceleration figure was chosen for 1/4.

## 7a. Encoder

With the chain on and the arm homed, the status line should show `enc=` with an angle
and `err=` close to zero.

1. If flexing makes `enc=` fall while `angle=` rises, set `kEncoderInvert` to `true`.
2. Run the full travel at normal speed several times and note the largest `err=`.
3. Stopped mid-travel, press the forearm by hand both ways and note how far `enc=`
   moves. That is chain slack and worm backlash together.
4. Set `kEncoderToleranceDeg` above both, with some margin. A tolerance that trips in
   normal use will get disabled.
5. Take the chain off a sprocket with the motor stopped, or hold the output and step
   the motor with the current limit low. It must fault with `encoder disagrees`.
6. Unplug the encoder. It must fault once, then show `enc=LOST`.

## 8. Interlocks under motion

Each of these, with the arm moving:

- [ ] Press the e-stop. The motor must go dead immediately, and the monitor
      print `FAULT: estop`.
- [ ] Press the e-stop while the arm is already faulted. The motor must still go
      dead, with `drive=off` in the status line.
- [ ] Release the e-stop. The arm must **not** resume, even with a button
      still held. It should print `ready` only once both buttons are up.
- [ ] Release the button. The arm must ramp down, not stop dead.
- [ ] Press both buttons together. The arm must stop.
- [ ] Pull the pendant connector. Same behaviour as the e-stop.

The last one is the test people skip. A severed pendant cable must read as
stop, and that is only true if the e-stop contact is normally closed.

## 9. Holding test

**Do not wear the arm until you have done this.** It decides what the machine does
when power is lost. Motovario's figures say a 30:1 worm should hold, but check the
figures for the gearbox you bought and do not assume it: see [loads.md](loads.md).

Unworn, with a weight in the forearm cuff at least as heavy as the arm it will
carry. Keep hands and face out of the forearm's path, because it may drop.

1. Stop mid-travel with the forearm horizontal.
2. Press the e-stop, which removes motor current.
3. Watch for at least a minute and measure any movement at the cuff. Also try the
   assist cord's effect by repeating with no weight, since it may pull the forearm
   upward.
4. Repeat near both ends of travel.

| Result | What it means |
|---|---|
| No movement in any test | The drivetrain holds. You may set `kDeenergiseWhenIdle` to `true` and repeat with the extra load you plan to carry |
| Any creep or drop | It back-drives. Leave `kDeenergiseWhenIdle` off, and treat a forearm drop as what happens at every e-stop and power failure. That needs a motor brake before anyone wears it |

Vibration can release a worm that looks locked when still, so a pass here is a
good sign rather than a guarantee. It also says nothing about a moving arm: at this
ratio the catalogue does not expect the worm to stop instantly in motion, so also press
the e-stop mid-move and measure how far the forearm runs on. With holding current on,
also check motor and
driver temperature after 30 minutes stopped.

## 10. Speed, loaded

With a representative weight in the cuff, run the full travel. 20°/s should
feel unhurried. If the motor stalls or skips — a buzz without motion — reduce
`kMaxSpeedDegPerSec` and `kAccelDegPerSec2` before raising the driver
current.

Record what the supply draws, from the `amps=` field in the status line:

| Condition | Figure to record |
|---|---|
| Before the first motion after power-on | Should read near zero. If not, the zero calibration at boot caught something moving |
| Moving, unloaded | The floor the collapse threshold sits below |
| Moving, loaded | The normal working figure |
| Deliberately obstructed, briefly | The level the overload threshold sits below |

Then set the thresholds in `config.h`:

- `kCollapseAmps` about half the unloaded moving figure
- `kOverloadAmps` midway between the loaded working figure and the obstructed
  one

The values shipped are placeholders estimated for the 23HS16 at the 2.0 A starting
setting. Set too low they will trip during normal use, and a safety device that
cries wolf gets disabled; set too high they catch nothing.

Obstruct the arm by hand against a bench, not against a person, and keep it
brief.

### Setting the current down, deliberately

While you are at the DIP switches, this is the one place the arm's peak force
can be reduced, and it is worth doing on purpose rather than leaving at
whatever the switches came set to.

Stepper torque follows phase current, and the TB6600 holds phase current at
whatever the switches say, so that setting decides how hard the arm can push.
The firmware cannot reduce it: there is no state between stepping and
stopped, which is why the overload monitor is a trip rather than a limit. It
notices too much force is already going in and cuts the drive. Everything up
to the threshold reaches the wearer.

At the motor's rated 2.8 A the drivetrain can deliver about 12 to 21 N·m against a
static load of about 2.9. Start at 2.0 A, which gives about 9 to 15 N·m, and never go
above 2.8 A. See [loads.md](loads.md).

1. Find the lowest current setting that moves the arm, loaded, through full
   travel without skipping. Note it.
2. Go up one step from there, for drivetrain losses as it wears and for a
   carried load.
3. Stay there. Do not set it higher because there is headroom on the driver.

The trade is honest and runs both ways: lower current means a smaller stall
margin, so more lost steps, which the home switch will show you as growing
drift. Higher current means a harder push into whatever the arm meets. Pick
from measurement rather than from the datasheet, and redo the thresholds
above afterwards, because they move with it.

The clutch is the fix that still holds when the firmware is wrong, and it comes next.

## 10a. Clutch

Set the slip torque by following [torque-limiter.md](torque-limiter.md#setting-it), with
the arm unworn and a spring scale at the cuff. It should slip at 35 to 45 N, and doing so
should fault the arm through the encoder. **Do not go on until it does both.** If it slips
without a fault, the encoder is not on the forearm side of the clutch.

Repeat the holding test in step 9 afterwards, since the clutch is now in that load path.

## 11. Load monitoring

With the thresholds set, confirm both trips fire:

- [ ] Obstruct the arm while it drives. It must fault within about half a
      second and print `FAULT: overload`
- [ ] Disconnect the motor and command motion. It must fault and print
      `FAULT: current collapse`
- [ ] Run the full travel loaded, several times, with no false trips

The third is the one that decides whether the thresholds are usable. A
monitor that trips during normal use will be turned off, and then it protects
nothing.

## 12. First wear

Follow the checklist in [safety.md](safety.md). Short presses, not long ones.
Someone else on the e-stop.
