VK12034/exo-arm/(commit log)

2026-11-04 Initial project: firmware, host tools and build documentation
    Two-DoF powered exoskeleton arm supporting shoulder and elbow flexion in
    the sagittal plane.
    Firmware (Teensy 4.1, PlatformIO):
    - 1 kHz control loop from a hardware timer, independent of the serial link
    - Closed-form two-link gravity feed-forward so the PID gains can stay low
    - Position PID with derivative on measurement and conditional integration
    - Soft-limit shaping, velocity and current ceilings, duty slew limiting
    - Safety state machine: e-stop loop, deadman switch, host watchdog, latched
    faults that refuse to clear while their cause is present
    - CRC-checked binary serial protocol with a resynchronising parser
    Host tools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
    [config.h, main.cpp]
2026-11-04 Add the real Fusion CAD and a script to regenerate its exports
    The repository described a machine that does not exist. This adds the actual
    design and the measured numbers that come out of it.
    - cad/source/BudgetExoArm.f3d, plus STEP and STL exports and a render
    - cad/BudgetExoArm.design.json and .bodies.csv: per-body mass, volume and
    centre of mass for all 82 solid bodies
    - tools/fusion/ExoArmExport.py: read-only Fusion script that regenerates all
    of the above, so the numbers stay tied to the model
    What the model actually is: a single-degree-of-freedom powered elbow. A
    NEMA 23 stepper through an NMRV030 15:1 worm drives the elbow directly, a
    sling and waist belt carry the shoulder, an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
    [BudgetExoArm.bodies.csv, BudgetExoArm.f3d, BudgetExoArm.step, BudgetExoArm.stl]
2026-11-04 Replace the firmware with one for the machine that exists
    The previous firmware targeted a Teensy 4.1 driving two brushed DC joints
    with encoders, current sense and load-cell admittance control. The CAD has
    none of that. This rewrites it for the real hardware.
    Firmware (Arduino Uno, PlatformIO):
    - Velocity planner: ramps at 45 deg/s^2 to 20 deg/s, and decelerates to rest
    at the travel limits rather than arriving at them under power
    - Step generator: 10 kHz timer interrupt, 16.16 fixed-point accumulator, no
    floating point in the ISR, with its own travel clamp independent of the
    planner
    - Pendant: 25 ms debounce; both buttons or neither reads as stop
    - Boots into fault; leaves it only w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
    [config.h, debounce.h, main.cpp, motion.h, pendant.cpp, pendant.h, stepper.cpp]
2026-11-04 Stop inside the travel limits, and guarantee zero on reversal
    Two bugs the native tests caught before any of this reached hardware.
    The deceleration margin used the ideal stopping distance, v^2/2a. Slowing
    down happens in discrete ticks, so the distance actually covered is about
    half a tick's travel more than that, and the decision is taken a tick before
    the motion it governs. The arm therefore ran a few steps past the soft limit
    every time. The margin now carries one extra tick of travel.
    The velocity ramp could cross from positive to negative without ever
    landing on zero, because the step size does not divide the top speed. The
    step generator only moves the direction line while stopped,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
    [motion.h]
2026-11-04 Allow for truncated step counts in the deceleration margin
    Position reaches the planner as a whole step count. Travelling away from
    zero that count rounds down, so the arm can be up to one step further along
    than it is reported to be, and the planner was spending that step crossing
    the limit: 1.33 steps past it going up, where coming down stopped short.
    Adding a step to the margin removes the asymmetry and leaves the stop inside
    the limit in both directions. It is 0.02 degrees of travel, which matters
    not because the overshoot is dangerous but because the soft limit should be
    a line the planner does not cross: the step generator's own clamp is there
    to catch a fault, not to finish the plann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
    [motion.h]
2026-11-04 Watch the driver's supply current while the arm is driving
    A bind or an obstruction previously had no consequence: the motor kept
    stepping, the counter kept counting, and the firmware went on believing the
    arm was somewhere it was not.
    An ACS712 in the 24 V feed to the driver gives the firmware a view of
    mechanical power. Two signatures fault the arm while it is being driven:
    sustained current above what moving it should need, which means it is
    pushing against something, and current collapsing to near idle while steps
    are still being commanded, which is consistent with a lost rotor or a
    disconnected motor. Both wait out a grace period after motion starts so the
    inrush at the first step is n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
2026-11-05 Reference the travel counter to a switch at full extension
    The soft limits were counted steps from an assumed pose. Park the arm wrong
    and every limit moved with it, in the same direction, by the same amount,
    with nothing to say so. safety.md listed that as a known gap.
    A lever microswitch at the extension end gives the counter something physical
    to be referenced to. Reaching it sets zero. Until it is reached the firmware
    treats the count as the assumption it is and holds the arm to 90 degrees at
    5 deg/s, so a parking error costs range rather than putting the elbow
    somewhere it should not be.
    It does not home by itself. The one rule this machine has is that it moves
    only while a human hold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
    [config.h, homing.h, main.cpp, test_motion.cpp]
2026-11-05 Stop claiming hard stops the design does not have
    safety.md has described three layers behind the travel limits since the first
    commit: the planner decelerating to rest, the step generator refusing to
    pulse past on its own arithmetic, and mechanical hard stops behind both. The
    first two are real and unit tested. The third is not in the Fusion model. Of
    its 82 bodies none is a travel stop, and the switch added in the last commit
    has no mount either.
    That is the wrong way round. The physical backstop is the layer that matters
    precisely when the firmware is wrong, which is the case it exists for, and it
    was the one being taken on trust.
    No geometry here, since the CAD is a binary Fusion file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
    [config.h]
2026-11-05 Keep faults and homing drift in EEPROM across power cycles
    Two things vanished at exactly the wrong moment.
    A fault reason. The LED blinks, the wearer switches off to get the arm away
    from themselves, and what it was goes with the power. The one time you most
    want to know is the one time you cannot ask.
    And the homing drift figure. A single correction says nothing; the trend
    across sessions is the only diagnostic this machine has for step loss, and
    commissioning was asking for it to be kept on paper.
    Both now go to EEPROM. The last 16 events, each tagged with a session number,
    printed at power-on as part of the banner.
    Printed at power-on and nowhere else, which is the part worth being e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
    [journal.h, main.cpp, test_motion.cpp]
2026-11-05 Add an overrun switch past the flexion limit, and use it to check microstepping
    The flexion end had no physical anything. The soft limit at 135 degrees was
    arithmetic from the home switch, and the two things enforcing it, the planner
    decelerating and the step generator's independent clamp, are both firmware.
    Both are unit tested, which is the reason to want something watching for them
    being wrong rather than a reason not to.
    So: a second lever switch at about 138 degrees, three degrees past the soft
    limit. It is not a limit and it is not sited like one. Reaching it means the
    planner and the clamp both failed, so it faults rather than stopping, and
    three degrees is far enough that a normal f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
    [config.h, journal.h, main.cpp, overrun.h, test_motion.cpp]
2026-11-05 Say plainly that the firmware cannot limit torque
    safety.md listed "no torque limit" as a gap in a way that read like missing
    work. It is not missing work; it is not possible on this hardware, and
    treating it as a to-do invites someone to try solving it in the planner.
    A TB6600 regulates phase current to its DIP setting, and a stepper's torque
    follows phase current. So the force the arm can push with is fixed in
    hardware. It does not drop when the firmware commands a lower speed, and
    slowing down does not ease off against an obstruction: stepper torque rises
    as speed falls, so a slow command pushes at least as hard as a fast one.
    There is no software state between stepping and stopped.
    Whi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
2026-11-05 Replace the CAD with the real chain-driven design
    The earlier export came from a timeline rolled back to a mid-edit state: no
    forearm strut, no hard stops, and a gearbox on the elbow. The finished design
    has a #35 chain stage, the gearbox mid upper arm, steel hard stops and an
    assist cord.
    - Correct materials left as steel on the gearmotor, cuffs, pads and straps
    - Add brackets, spacers and lever switches for the home and overrun switches,
    checked through the joint's full travel
    - Export script now reads as-built joints, exports the .f3d, writes no local
    paths, and refuses to run on a rolled-back timeline
    [BudgetExoArm.bodies.csv, BudgetExoArm.f3d, BudgetExoArm.step, BudgetExoArm.stl]
2026-11-05 Match the firmware to the chain-driven drivetrain
    The ratio is 30:1 with the chain stage, not 15:1, so every reported angle was
    double the real one.
    - 133.33 steps per degree
    - Zero at the home switch, soft limit 88, overrun switch 91, unhomed limit 60,
    from the 96 degrees the hard stops allow
    - Keep holding current when idle by default. Nothing has shown the 15:1 worm
    holds a loaded arm without current
2026-11-05 Rewrite the docs for the machine in the CAD
    Correct the drivetrain, travel, masses and BOM. Replace the claim that the worm
    is self-locking with a holding test that must pass before the arm is worn. Add
    the chain's hazards and the gaps that remain: no chain guard, no torque limiter,
    and hard stops and chain not checked against stall loads.
2026-11-05 Add a chain guard, encoder mount and working stop bumpers to the CAD
    - Chain guard around both sprockets, held by two pillars through the upper strut
    - Magnet cup on the sprocket bolts and an AS5600 board on an arm from the guard
    - Rubber sleeves in the strut's plane, because the old ones sat above it and never
    touched it. Contact diameter is unchanged, so the stop angles are too
    - Checked at 10 elbow angles with no clashes involving the new parts
    [BudgetExoArm.bodies.csv, BudgetExoArm.f3d, BudgetExoArm.step, BudgetExoArm.stl]
2026-11-05 Add an elbow encoder, and stop faults from cutting motor current
    Every fault used to cut the current. Motovario lists this worm as not self-locking,
    so a firmware fault could have dropped the forearm by itself. Only the e-stop cuts
    it now, including when pressed during another fault.
    An AS5600 on the elbow compares the measured angle with the step count, stopped or
    moving. A sustained disagreement faults the arm and returns it to restricted travel.
    A lost sensor faults once, then the arm carries on step-counted.
2026-11-05 Document the worm figures and stall loads
    Add docs/loads.md and tools/stall_loads.py. Motovario lists the NMRV030 at 15:1 with
    a static efficiency of 0.55, above the 0.5 it requires for self-locking, so the docs
    now say plan on the forearm moving when current is lost, and cover a 30:1 worm with a
    1:1 chain as the way out. At full current the top of the range exceeds the hard stop
    bolt's bending limit, so commissioning now starts from about 40% of rated current.
2026-11-05 Switch to a 30:1 worm and a smaller motor
    The 15:1 worm's static efficiency of 0.55 does not meet the catalogue's 0.5
    limit for holding a load, so the design moves to a 30:1 worm at 0.39.
    Keep the 2:1 chain and use a 0.55 N.m motor, for 60:1 overall. That needs no
    new sprockets, chain or guard, and it lowers the most the arm can push from
    158-223 N to 65-109 N at the cuff, whatever the driver current is set below
    rated. 1/4 microstepping keeps steps per degree the same.
    Lower the overload placeholder to 0.6 A, since this motor would not reach
    the old 2.5 A. Update the load script and docs, and note that the Fusion model
    still shows the earlier gearbox and motor.
2026-11-05 Update the CAD to the 30:1 worm and smaller motor
    Shorten the motor body from 76 mm to 41 mm, move its rear cap and lead exit
    with it, reroute the motor cable to the new exit, and rename the gearbox to 30:1.
    The motor now weighs the listing's 0.55 kg, which takes the device from 4.160 kg
    to 3.618 kg. Every other body keeps its mass, position and size.
    Re-export the Fusion archive, STEP, STL, body data and image, and update the
    masses and notes in the docs.
    [BudgetExoArm.bodies.csv, BudgetExoArm.f3d, BudgetExoArm.step, BudgetExoArm.stl]
2026-11-05 Add a friction torque limiter at the 30T sprocket
    Clamp the sprocket between two friction facings on four spring-loaded bolts,
    to be set to slip near 8 N.m, about 41 N at the cuff. The stack takes the 5 mm
    the sprocket spacers used, so the chain line does not move. It has not been built,
    and its friction is assumed.
    Mount the encoder magnet cup on the outer plate so it stays on the forearm side
    and a slip faults the arm. Bore the sprocket to 52 mm, shorten the hard stop bolts
    so they end below the plate, and remove the unused end caps from the model.
    Add the sizing script, the setting procedure and a check before every session.
    Device mass is now 3.787 kg.
    [BudgetExoArm.bodies.csv, BudgetExoArm.f3d, BudgetExoArm.step, BudgetExoArm.stl]
2026-11-07 Add printable parts and fix the wiring and pivot docs
    Export one STL per 3D-printed part to cad/parts, and have the export script
    write them too.
    Feed the Uno from its 5V pin, since VIN needs about 7 V or more. Specify the
    e-stop relay: a bare 5 V coil held in through the normally closed contact, with a
    flyback diode.
    Add a retaining spacer on the pivot, because nothing located the forearm along the
    bolt. It is not in the Fusion model yet. Note that the strut's slots tension the
    chain.
    [chain-guard.stl, control-box-body.stl, control-box-lid.stl, encoder-magnet-cup.stl, forearm-cuff.stl, gearbox-plate.stl, hand-pendant-housing.stl, sling-strap-anchor.stl]
2026-11-09 Model a real control box and pendant, and the pivot spacer
    The control box, lid and pendant were simple blocks. Rebuild them around real
    parts: the box opens away from the wearer with the belt loops on its back wall,
    has Uno bosses, room for a 96 x 71 x 37 mm driver, gland, USB and vent openings,
    and a lid cut for the rocker, LED and jack. The pendant is now hollow, 55 mm deep
    so a 22 mm e-stop fits, with a screw-on back cover.
    Add the sling anchor's bolt hole and the pivot retaining spacer to the model.
    Device mass is now 3.741 kg.
    [BudgetExoArm.bodies.csv, BudgetExoArm.f3d, BudgetExoArm.step, BudgetExoArm.stl, control-box-body.stl, control-box-lid.stl, hand-pendant-back-cover.stl, hand-pendant-housing.stl]
